pib-ucsd/robotic-arm/(commit log)

2022-09-03 Comment out serial print
2023-05-14 add assembly picture to readme
2023-05-14 update assembly picture in readme
